hexagon5un/vusb_tiny_designs/vusb-tiny-programmer.jpg

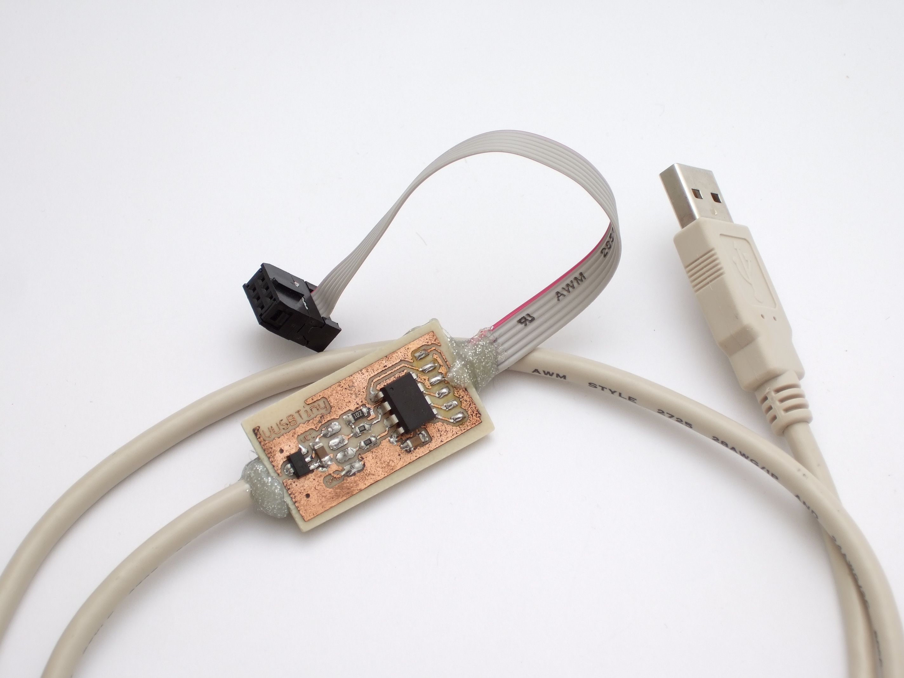
vusb-tiny-programmer.jpg
