hexagon5un/vusb_tiny_designs/vusbtinyisp_smt.pdf

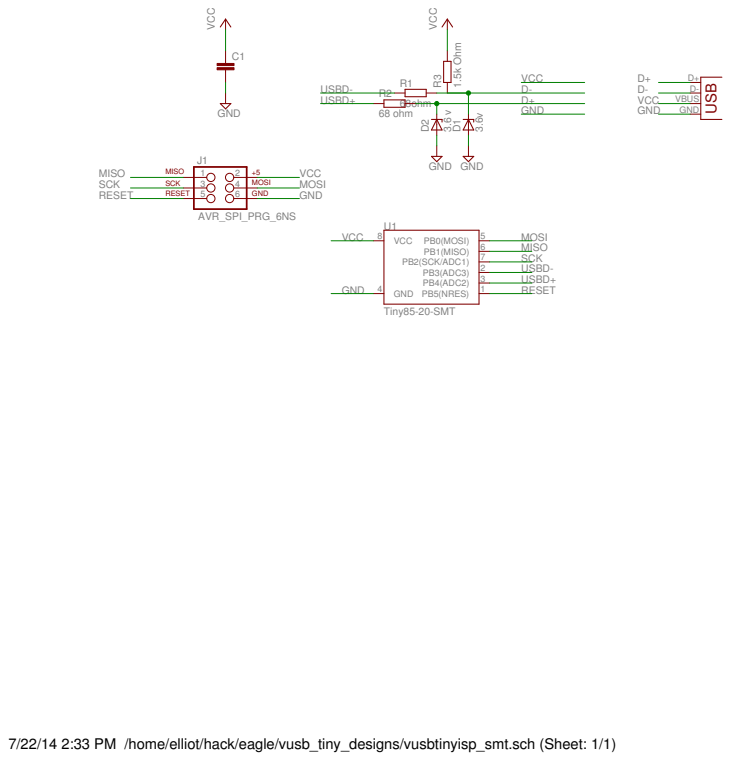
[picture p2: page 1]

7/22/14 2:33 PM /home/elliot/hack/eagle/vusb_tiny_designs/vusbtinyisp_smt.sch (Sheet: 1/1)
