hexagon5un/vusb_tiny_designs/vusbtinyisp_smt_voltage_reg.pdf

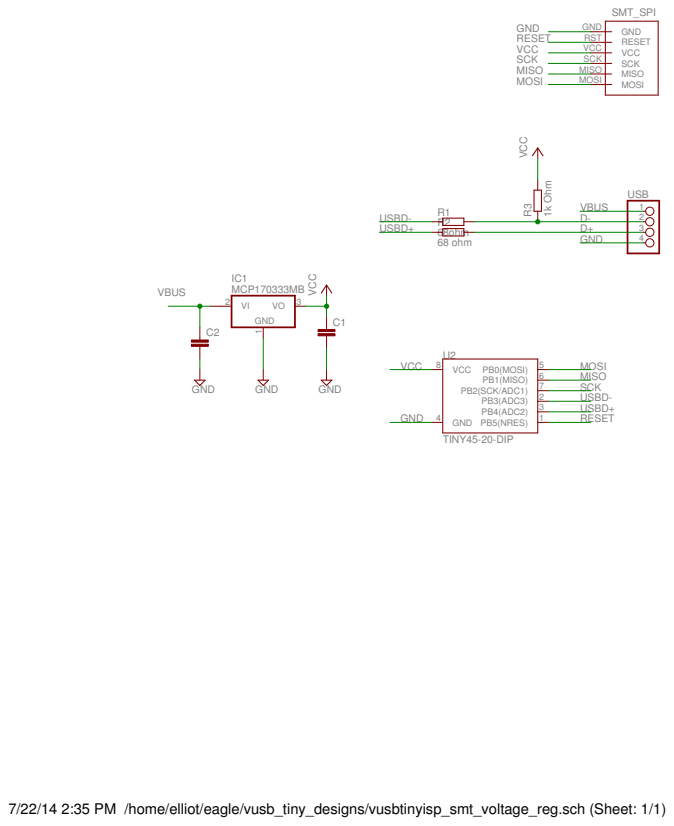
[picture p3: page 1]

7/22/14 2:35 PM /home/elliot/eagle/vusb_tiny_designs/vusbtinyisp_smt_voltage_reg.sch (Sheet: 1/1)
