hexagon5un/vusb_tiny_designs/vusbtinyisp_smt_inline/vusbtinyisp_smt_inline.brd

## EAGLE design vusbtinyisp_smt_inline/vusbtinyisp_smt_inline.brd (2014-07-22)

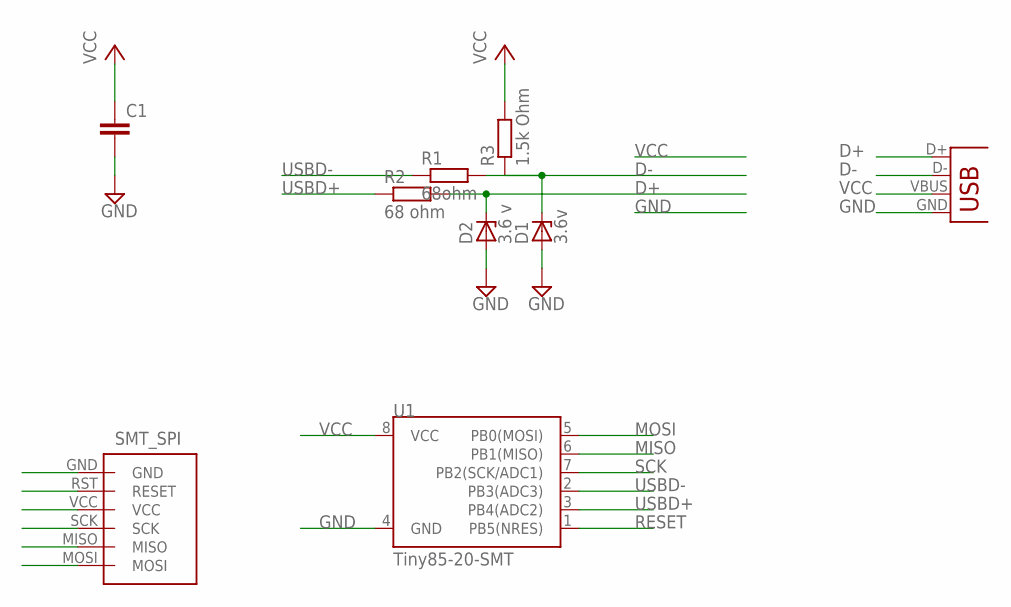
[picture p4: schematic vusbtinyisp_smt_inline.sch]

Parts:
C1: CAP1206; 1206
D1: 3.6v; SOT23
D2: 3.6 v; SOT23
JP2: USBSMD; USB-MINIB
R1: 68ohm; R0805
R2: 68 ohm; R0805
R3: 1.5k Ohm; R1206
U1: Tiny85-20-SMT; SO08-EIAJ
U$1: SMT_ISP; SMT_PADS

Connections:
D+: D2.3 (C), JP2.D+, R2.2
D-: D1.3 (C), JP2.D-, R1.2, R3.1
GND: C1.2, D1.1 (A), D2.1 (A), JP2.GND, U1.4 (GND), U$1.GND
MISO: U1.6 (PB1(MISO)), U$1.MISO
MOSI: U1.5 (PB0(MOSI)), U$1.MOSI
RESET: U1.1 (PB5(NRES)), U$1.RST (RESET)
SCK: U1.7 (PB2(SCK/ADC1)), U$1.SCK
USBD+: R2.1, U1.3 (PB4(ADC2))
USBD-: R1.1, U1.2 (PB3(ADC3))
VCC: C1.1, JP2.VBUS, R3.2, U1.8 (VCC), U$1.VCC

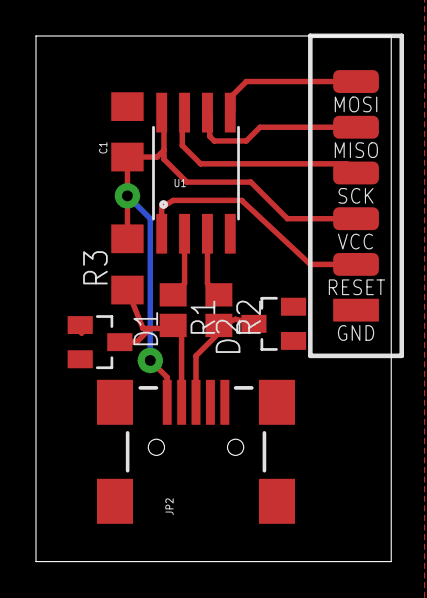
[picture p5: board vusbtinyisp_smt_inline.brd from above]

Board: 2 copper layers, 19.7 x 29.2 mm, 9 parts (0 on the bottom side), 10 nets.
