hexagon5un/vusb_tiny_designs/vusbtinyisp_through-hole/vusbtinyisp_through-hole.brd

## EAGLE design vusbtinyisp_through-hole/vusbtinyisp_through-hole.brd (2014-07-22)

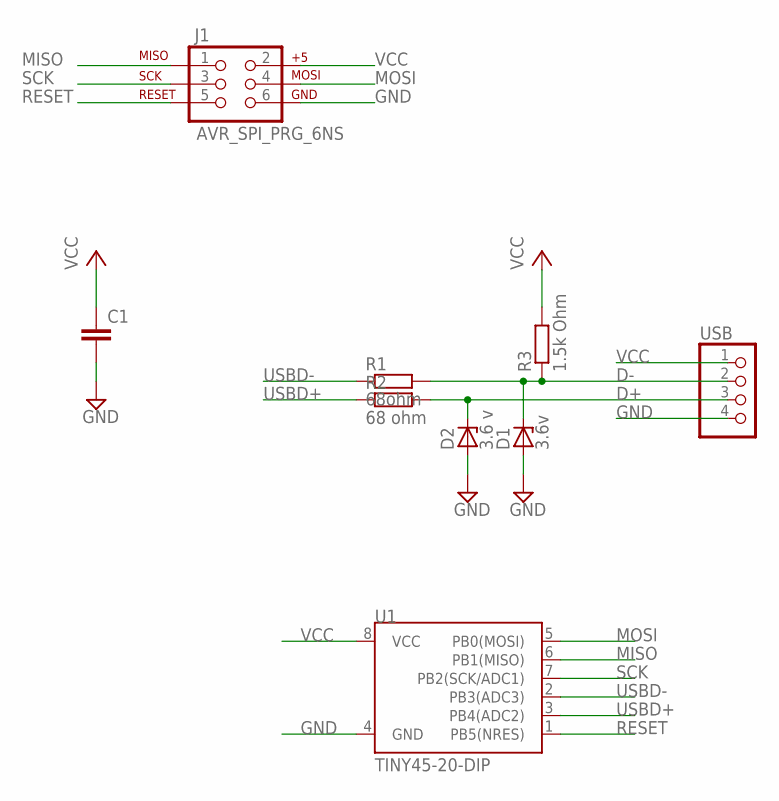
[picture p6: schematic vusbtinyisp_through-hole.sch]

Parts:
C1: CAPPTH; CAP-PTH-SMALL
D1: 3.6v; DO35Z10
D2: 3.6 v; DO35Z10
J1: AVR_SPI_PRG_6NS; 2X3-NS
R1: 68ohm; 0207/10
R2: 68 ohm; 0207/10
R3: 1.5k Ohm; 0207/10
U1: TINY45-20-DIP; DIP08
USB: PINHD-1X4; 1X04

Connections:
D+: D2.C, R2.2, USB.3
D-: D1.C, R1.2, R3.1, USB.2
GND: C1.2, D1.A, D2.A, J1.6, U1.4 (GND), USB.4
MISO: J1.1, U1.6 (PB1(MISO))
MOSI: J1.4, U1.5 (PB0(MOSI))
RESET: J1.5, U1.1 (PB5(NRES))
SCK: J1.3, U1.7 (PB2(SCK/ADC1))
USBD+: R2.1, U1.3 (PB4(ADC2))
USBD-: R1.1, U1.2 (PB3(ADC3))
VCC: C1.1, J1.2, R3.2, U1.8 (VCC), USB.1

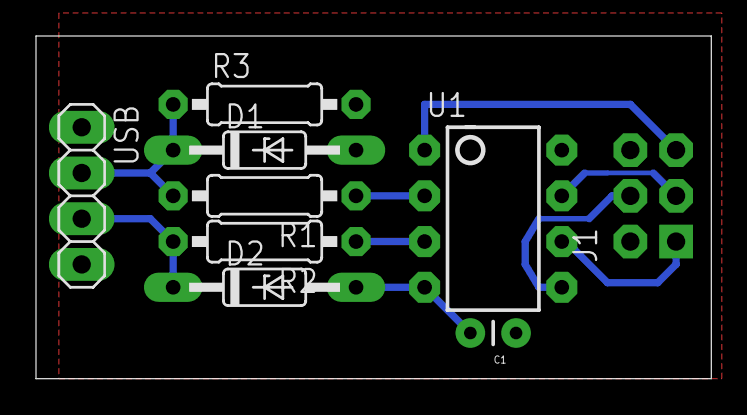
[picture p7: board vusbtinyisp_through-hole.brd from above]

Board: 2 copper layers, 37.5 x 19.0 mm, 9 parts (0 on the bottom side), 10 nets.
