hexagon5un/vusb_tiny_designs/vusbtinyisp_smt_voltage_reg/vusbtinyisp_smt_voltage_reg.brd

## EAGLE design vusbtinyisp_smt_voltage_reg/vusbtinyisp_smt_voltage_reg.brd (2014-07-22)

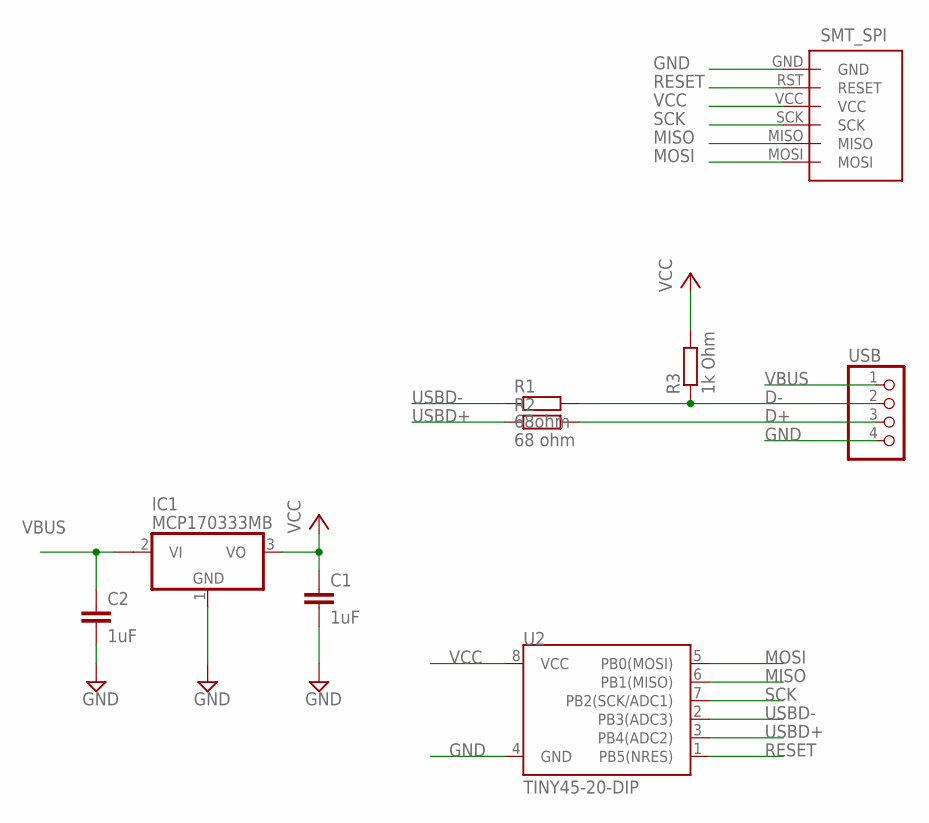
[picture p8: schematic vusbtinyisp_smt_voltage_reg.sch]

Parts:
C1, C2: 1uF; 1206
IC1: MCP170333MB; SOT89
R1: 68ohm; R0805
R2: 68 ohm; R0805
R3: 1k Ohm; R1206
U2: TINY45-20-DIP; DIP08
U$1: SMT_ISP; SMT_PADS
USB: PINHD-1X4; 1X04

Connections:
D+: R2.2, USB.3
D-: R1.2, R3.1, USB.2
GND: C1.2, C2.2, IC1.1 (GND), U2.4 (GND), U$1.GND, USB.4
MISO: U2.6 (PB1(MISO)), U$1.MISO
MOSI: U2.5 (PB0(MOSI)), U$1.MOSI
RESET: U2.1 (PB5(NRES)), U$1.RST (RESET)
SCK: U2.7 (PB2(SCK/ADC1)), U$1.SCK
USBD+: R2.1, U2.3 (PB4(ADC2))
USBD-: R1.1, U2.2 (PB3(ADC3))
VBUS: C2.1, IC1.2@1 (VI1), USB.1
VCC: C1.1, IC1.3 (VO), R3.2, U2.8 (VCC), U$1.VCC

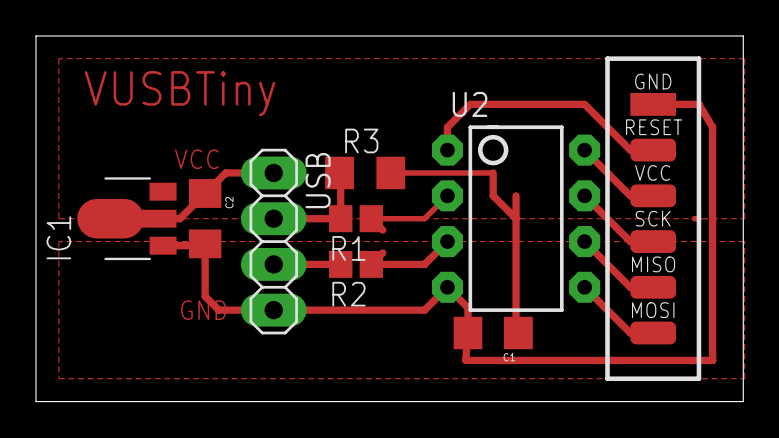
[picture p9: board vusbtinyisp_smt_voltage_reg.brd from above]

Board: 2 copper layers, 39.3 x 20.3 mm, 9 parts (0 on the bottom side), 11 nets.
