hexagon5un/vusb_tiny_designs/(commit log)

2014-07-21 initial commit -- SMT/VR version
    [vusbtinyisp_smt_voltage_reg.brd, vusbtinyisp_smt_voltage_reg.sch]
2014-07-21 set up versions for tweakification
    these are all clones of the trunk SMT version
    change parts to fit
    [vusbtinyisp_smt.brd, vusbtinyisp_smt.sch, vusbtinyisp_smt_inline.brd, vusbtinyisp_smt_inline.sch, vusbtinyisp_through-hole.brd, vusbtinyisp_through-hole.sch]
2014-07-21 complete, untested dip version
    [vusbtinyisp_through-hole.brd, vusbtinyisp_through-hole.sch]
2014-07-22 Added readme and PDF schematics
2014-07-22 changing 1k to 1.5k resistors in 5V designs
    [vusbtinyisp_smt.brd, vusbtinyisp_smt.sch, vusbtinyisp_smt_inline.brd, vusbtinyisp_smt_inline.sch, vusbtinyisp_smt_voltage_reg.brd, vusbtinyisp_smt_voltage_reg.sch, vusbtinyisp_through-hole.brd, vusbtinyisp_through-hole.sch]
2014-07-22 moving all files to their own directories
    [vusbtinyisp_smt.brd, vusbtinyisp_smt.sch, vusbtinyisp_smt_inline.brd, vusbtinyisp_smt_inline.sch, vusbtinyisp_smt_voltage_reg.brd, vusbtinyisp_smt_voltage_reg.sch, vusbtinyisp_through-hole.brd, vusbtinyisp_through-hole.sch]
2014-07-22 Created Gerbers and toner-transfer files
    [vusbtinyisp_smt.GBL, vusbtinyisp_smt.GBS, vusbtinyisp_smt.GTL, vusbtinyisp_smt.GTO, vusbtinyisp_smt.GTS, vusbtinyisp_smt_inline.GBL, vusbtinyisp_smt_inline.GBS, vusbtinyisp_smt_inline.GTL]
2014-07-22 note in readme about gerbers, silkscreens
